Mr-Cosine/EMG/Electronics/EMG sensor front end/layout/EMGintegrated/Assembly/unit.SLDASM

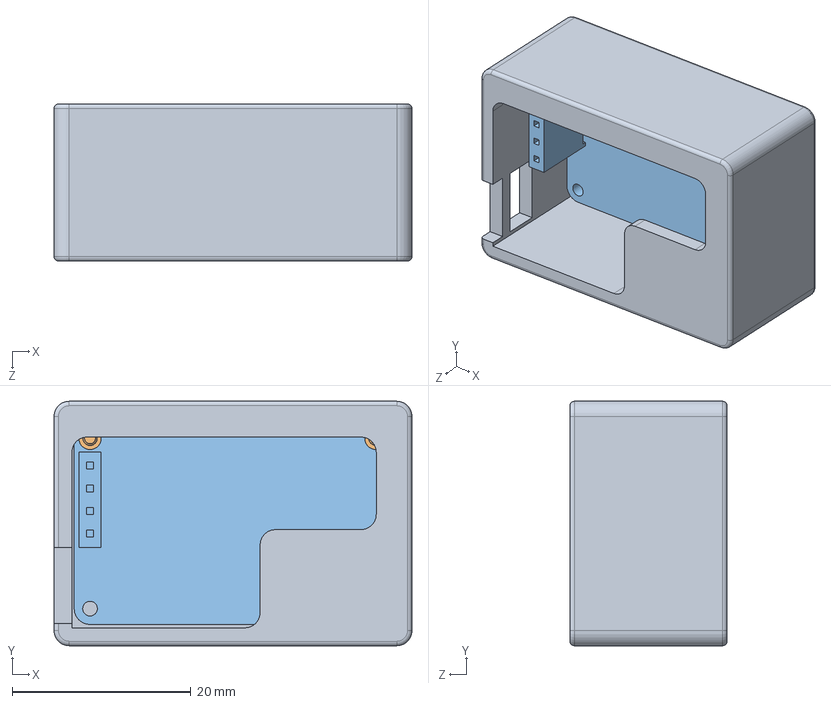
[picture p1: CAD file, 2026-11-11]
Electronics/EMG sensor front end/layout/EMGintegrated/Assembly/unit.SLDASM
40.1 x 27.4 x 17.6 mm
electrode
spacer x 3
