Mr-Cosine/EMG/Mechanical/finger/pinky nail v4.SLDASM

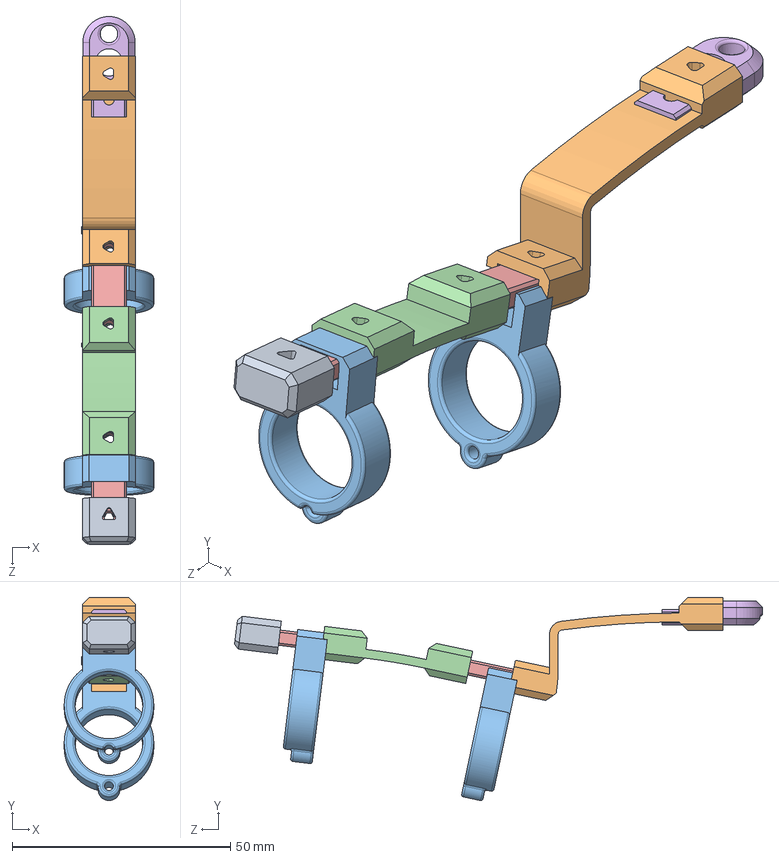
[picture p2: CAD file, 2026-10-28]
Mechanical/finger/pinky nail v4.SLDASM
20.5 x 46.5 x 120.8 mm
central support v5
beam v5 x 2
connector v5
new ring v5 x 2
connector - big v5
connector - tip v5
