Mr-Cosine/EMG/Mechanical/new hand - metal glider v5.SLDASM

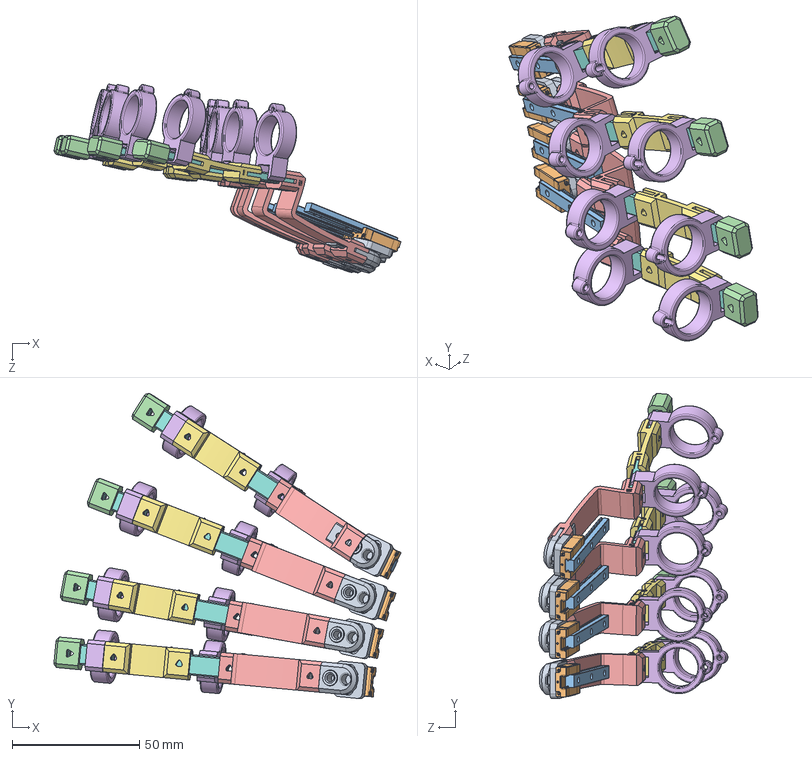
[picture p3: CAD file, 2026-10-28]
Mechanical/new hand - metal glider v5.SLDASM
136.6 x 120.2 x 74.3 mm
central support v5 x 4
beam v5 x 8
connector v5 x 4
new ring v5 x 8
connector - big v5 x 4
connector - tip v5 x 4
rail x 4
glider - metal x 4
glider base_4_CNC x 4
