Mr-Cosine/EMG/EMG fabric/finger/index&ring finger v4.SLDASM

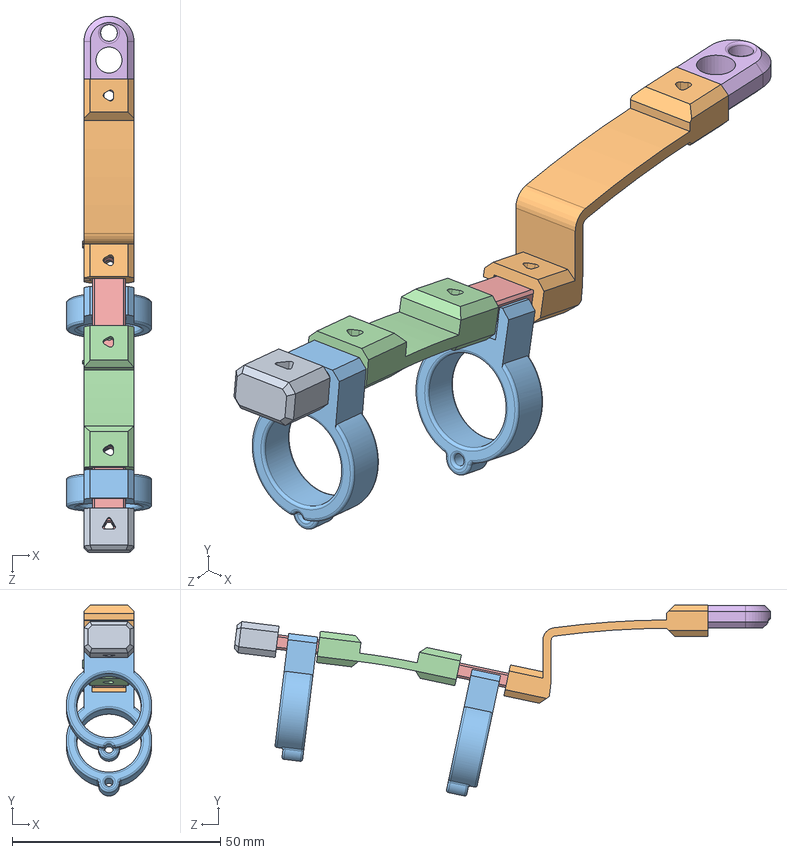
[picture p4: CAD file, 2026-09-22]
EMG fabric/finger/index&ring finger v4.SLDASM
20.5 x 45.8 x 128.7 mm
central support v5
beam v5 x 2
connector v5
new ring v5 x 2
connector - big v5
connector - tip v5
