Mr-Cosine/EMG/Mechanical/Arm/Hand/Hand.SLDASM

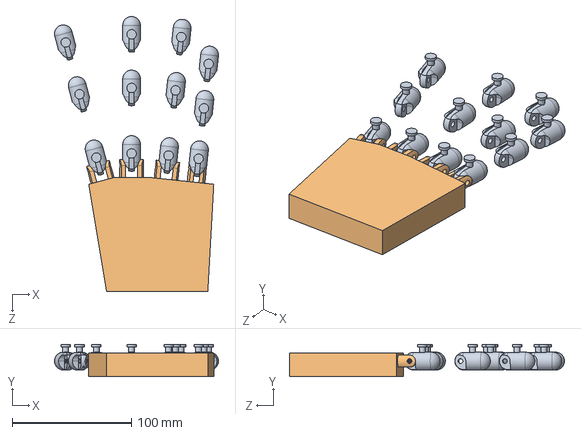
[picture p5: CAD file, 2026-11-11]
Mechanical/Arm/Hand/Hand.SLDASM
137.7 x 27.0 x 230.8 mm
palm
Finger_node x 12
