Mr-Cosine/EMG/Mechanical/Arm/Hand/Finger_smal.SLDASM

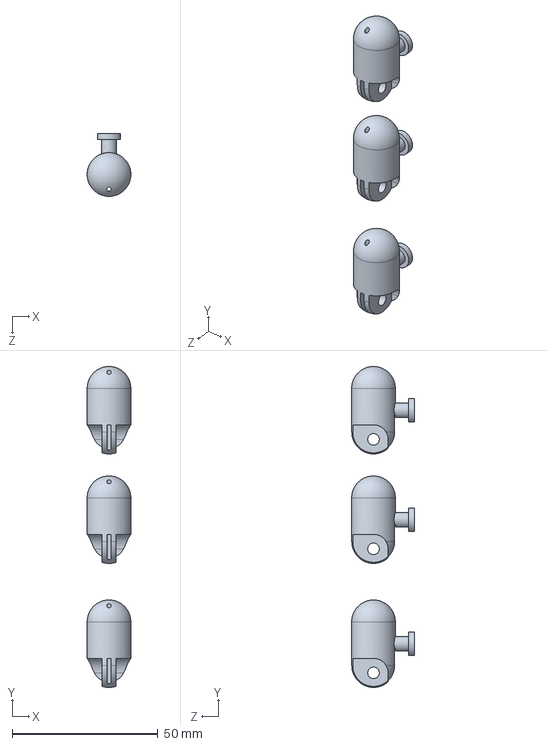
[picture p6: CAD file, 2026-11-11]
Mechanical/Arm/Hand/Finger_smal.SLDASM
15.0 x 110.0 x 21.5 mm
Finger_node x 3
