Mr-Cosine/EMG/Mechanical/Arm/Hand/Finger.SLDASM

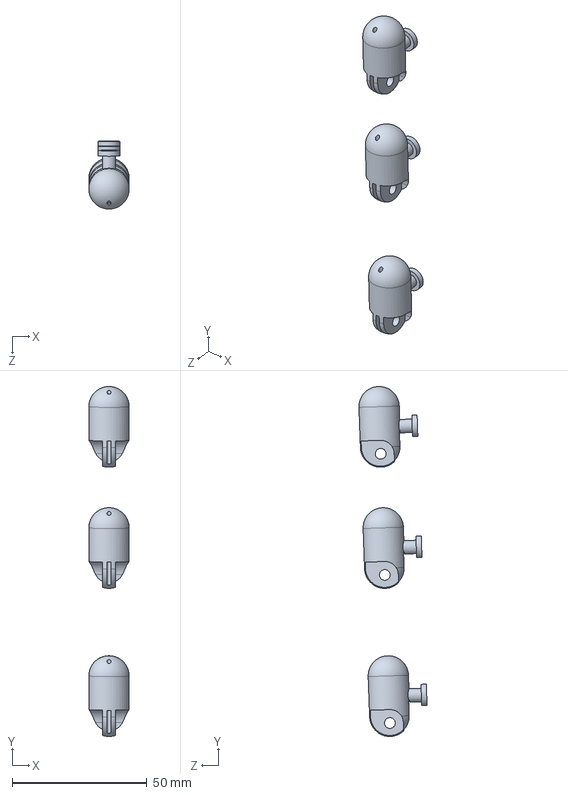
[picture p7: CAD file, 2026-11-11]
Mechanical/Arm/Hand/Finger.SLDASM
15.0 x 129.9 x 25.3 mm
Finger_node x 3
