Mr-Cosine/EMG/Electronics/EMG sensor front end/layout/EMGfrontend/Assembly/EMGfrontend.STEP

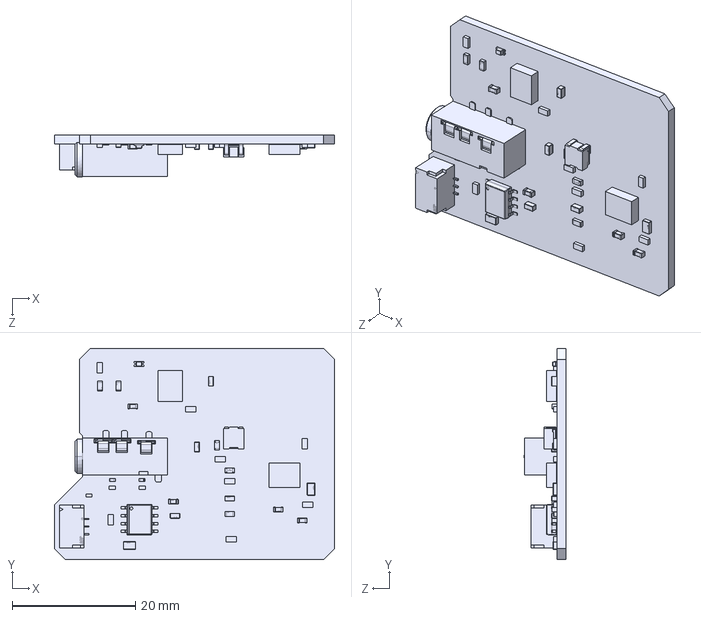
[picture p8: CAD file, 2026-11-10]
Electronics/EMG sensor front end/layout/EMGfrontend/Assembly/EMGfrontend.STEP
45.5 x 34.3 x 6.76 mm
