Mr-Cosine/EMG/EMG fabric/CAD drawing/glider base_4_CNC.STEP

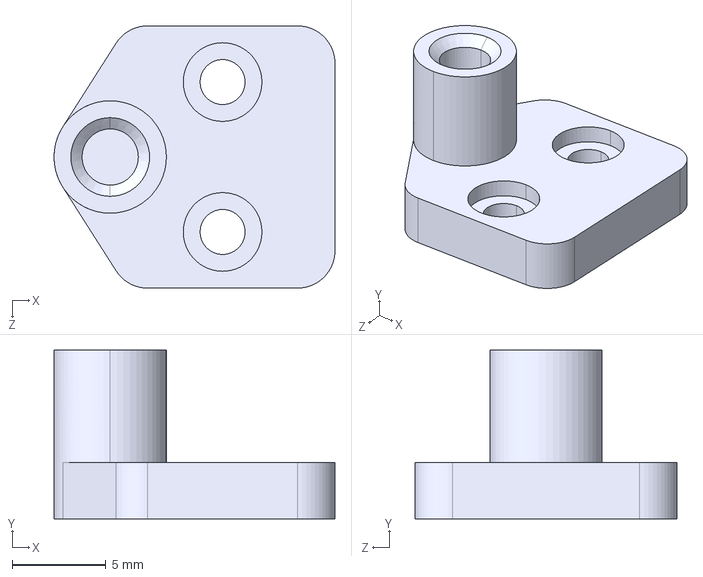
[picture p9: CAD file, 2026-09-22]
EMG fabric/CAD drawing/glider base_4_CNC.STEP
15.0 x 9.00 x 14.0 mm
