Mr-Cosine/EMG/EMG fabric/finger/connector - tip  v5.SLDPRT

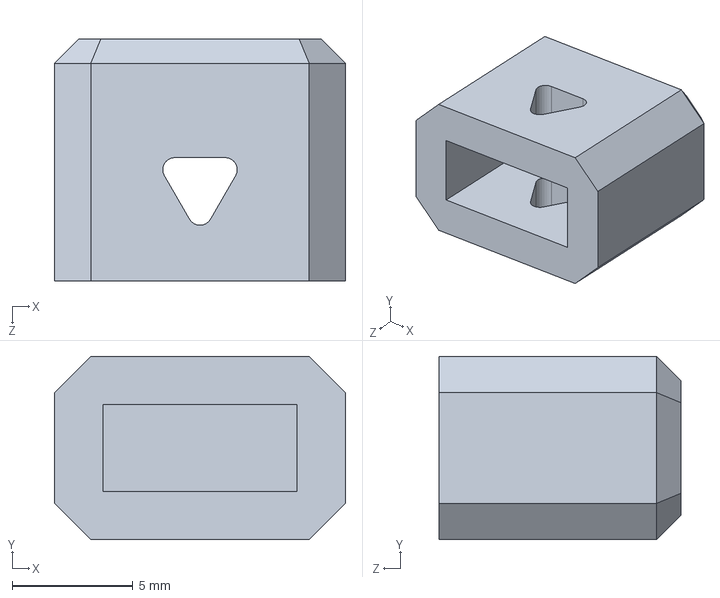
[picture p10: CAD file, 2026-09-22]
EMG fabric/finger/connector - tip v5.SLDPRT
12.0 x 7.58 x 10.0 mm
