Mr-Cosine/EMG/Mechanical/Arm/Hand/Finger_node_1-10scale.SLDPRT

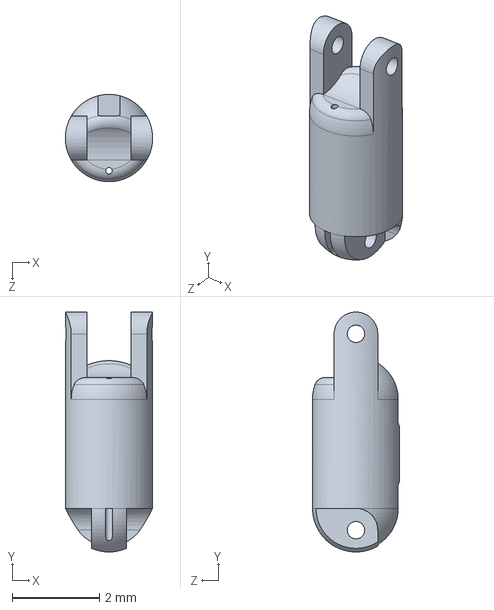
[picture p11: CAD file, 2026-11-11]
Mechanical/Arm/Hand/Finger_node_1-10scale.SLDPRT
2.00 x 5.50 x 2.00 mm
