Mr-Cosine/EMG/Electronics/EMG sensor front end/layout/EMGintegrated/Assembly/shell.SLDPRT

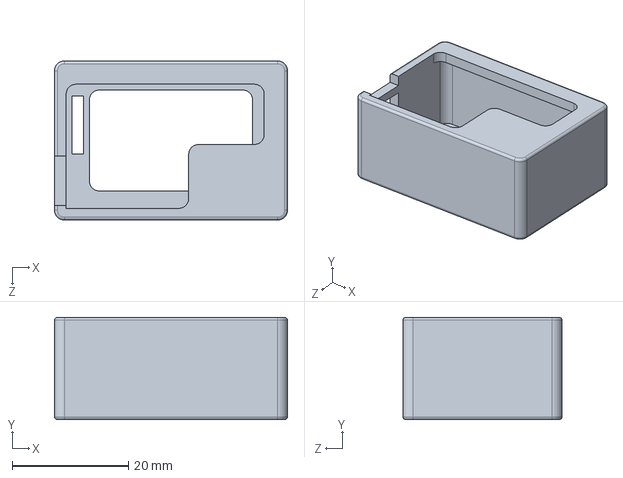
[picture p12: CAD file, 2026-11-11]
Electronics/EMG sensor front end/layout/EMGintegrated/Assembly/shell.SLDPRT
40.1 x 17.6 x 27.4 mm
