Mr-Cosine/EMG/Mechanical/Arm/Hand/palm.SLDPRT

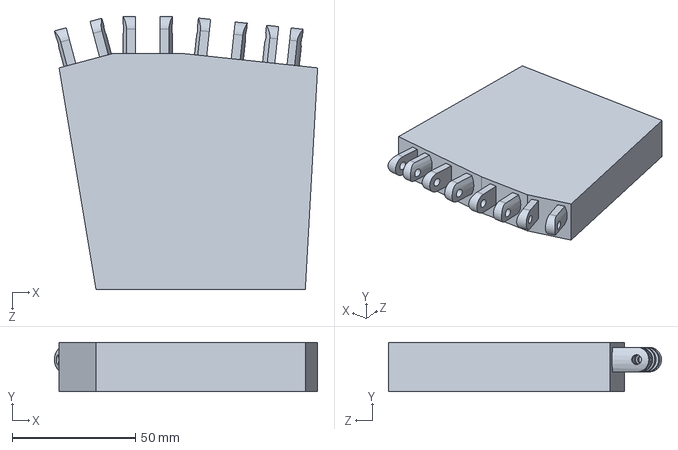
[picture p13: CAD file, 2026-11-11]
Mechanical/Arm/Hand/palm.SLDPRT
106.9 x 20.0 x 110.9 mm
