Mr-Cosine/EMG/Electronics/EMG sensor front end/layout/EMGintegrated/Assembly/electrode.SLDPRT

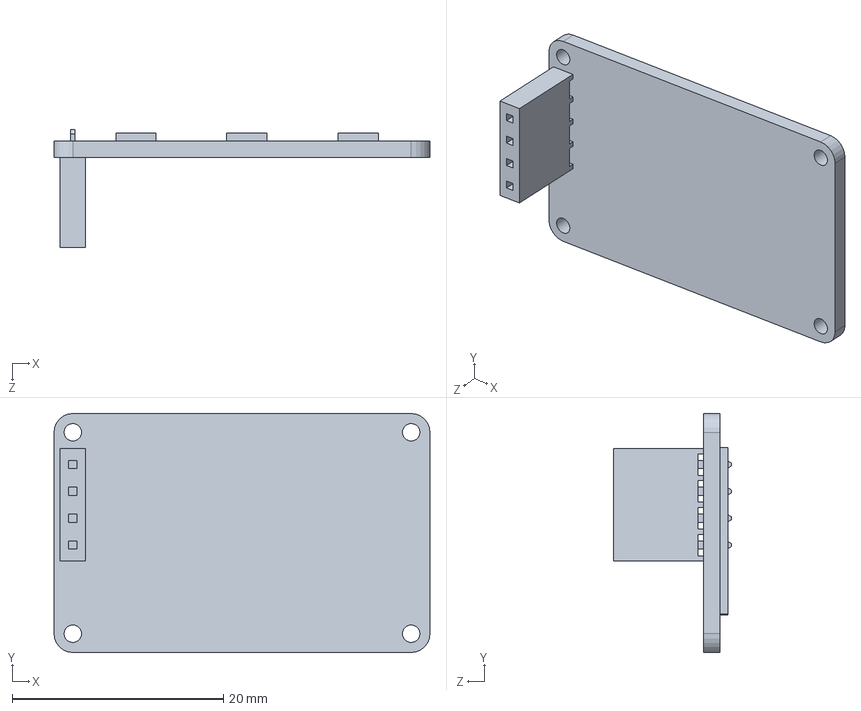
[picture p14: CAD file, 2026-11-10]
Electronics/EMG sensor front end/layout/EMGintegrated/Assembly/electrode.SLDPRT
35.6 x 22.6 x 11.2 mm
