Mr-Cosine/EMG/Mechanical/Arm/Hand/Finger_node.SLDPRT

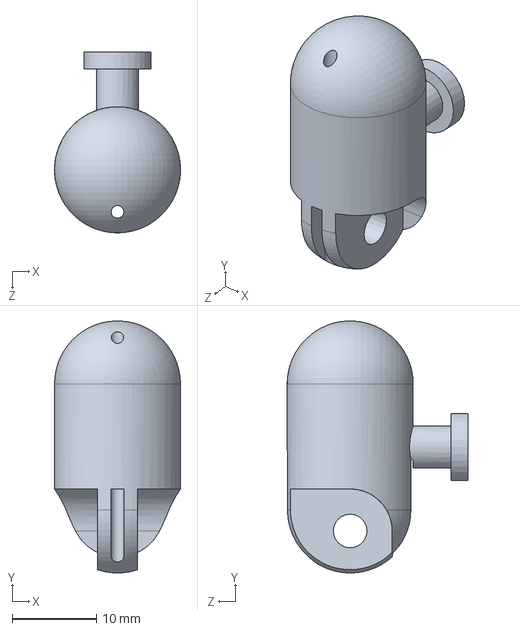
[picture p15: CAD file, 2026-11-11]
Mechanical/Arm/Hand/Finger_node.SLDPRT
15.0 x 30.0 x 21.5 mm
