Mr-Cosine/EMG/Mechanical/handpiece v6.SLDPRT

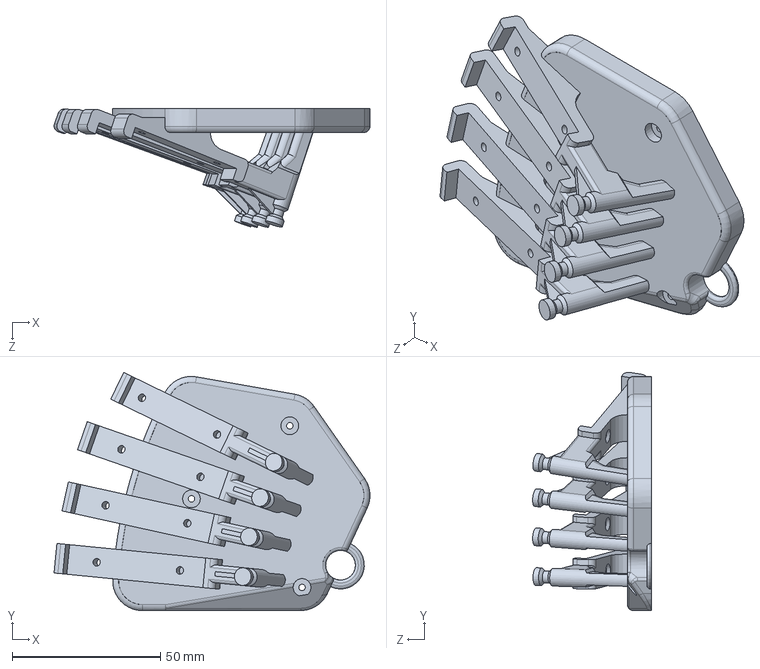
[picture p16: CAD file, 2026-09-29]
Mechanical/handpiece v6.SLDPRT
106.5 x 80.3 x 40.0 mm
