Mr-Cosine/EMG/Mechanical/Wearable hand exoskeleton/finger/connector v5.SLDPRT

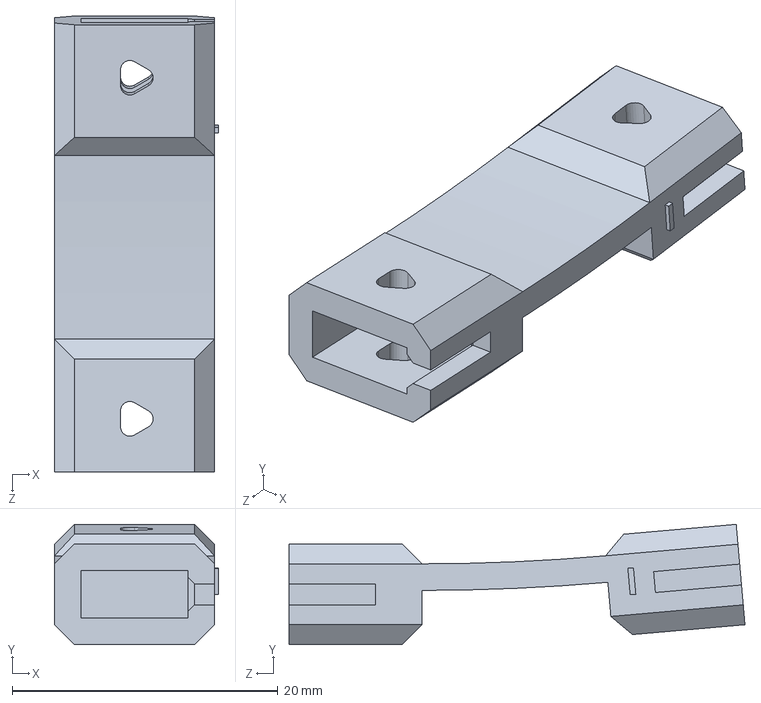
[picture p17: CAD file, 2026-11-11]
Mechanical/Wearable hand exoskeleton/finger/connector v5.SLDPRT
12.3 x 9.05 x 34.3 mm
