Mr-Cosine/EMG/Electronics/EMG sensor front end/layout/EMGintegrated/Assembly/EMGintegrated.SLDPRT

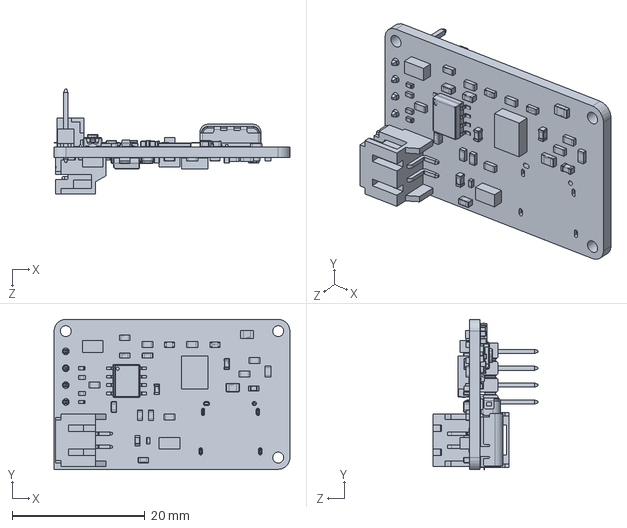
[picture p18: CAD file, 2026-11-10]
Electronics/EMG sensor front end/layout/EMGintegrated/Assembly/EMGintegrated.SLDPRT
35.6 x 22.6 x 15.8 mm
