Mr-Cosine/EMG/EMG fabric/finger/connector - big v5.SLDPRT

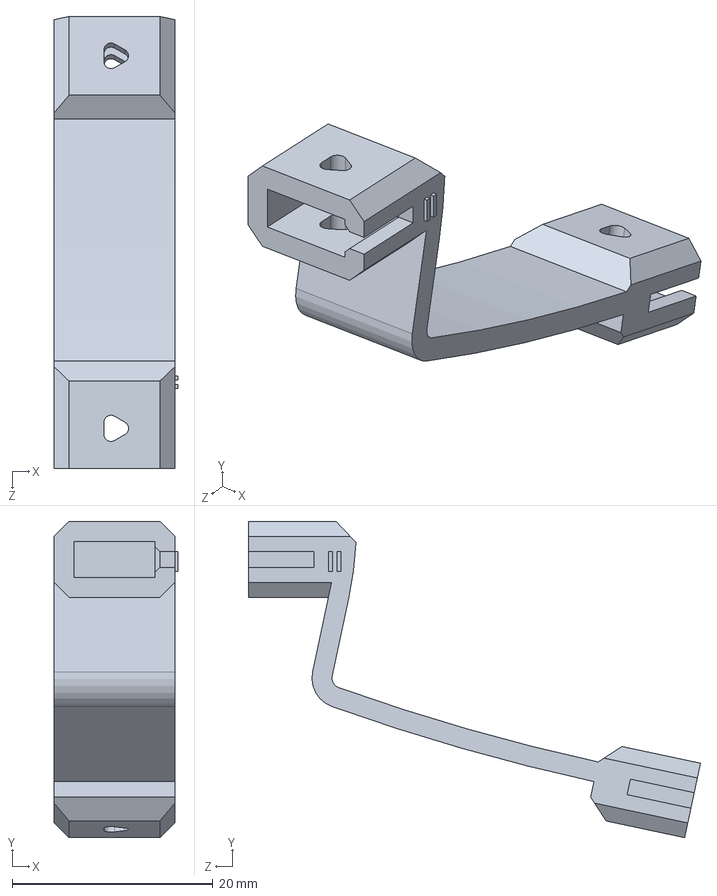
[picture p19: CAD file, 2026-09-22]
EMG fabric/finger/connector - big v5.SLDPRT
12.3 x 31.5 x 45.0 mm
