Mr-Cosine/EMG/Mechanical/armband_base.SLDPRT

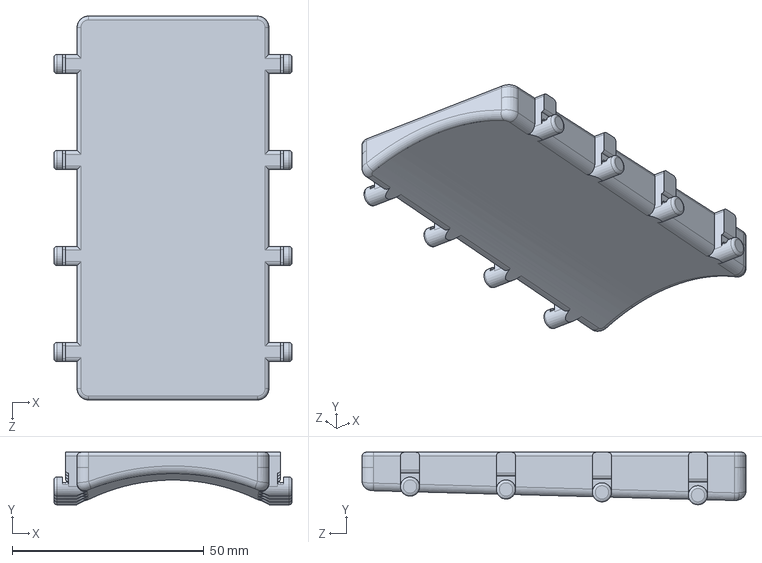
[picture p20: CAD file, 2026-09-22]
Mechanical/armband_base.SLDPRT
62.0 x 13.7 x 100.0 mm
