Mr-Cosine/EMG/Electronics/EMG sensor front end/layout/EMGintegrated/Assembly/spacer.SLDPRT

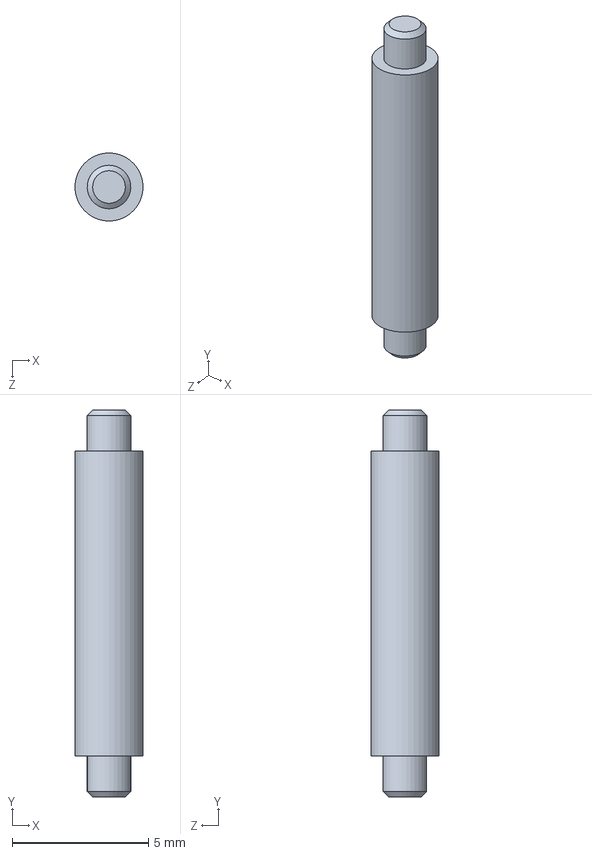
[picture p21: CAD file, 2026-11-10]
Electronics/EMG sensor front end/layout/EMGintegrated/Assembly/spacer.SLDPRT
2.49 x 14.2 x 2.50 mm
