Mr-Cosine/EMG/EMG fabric/finger/central support v5.SLDPRT

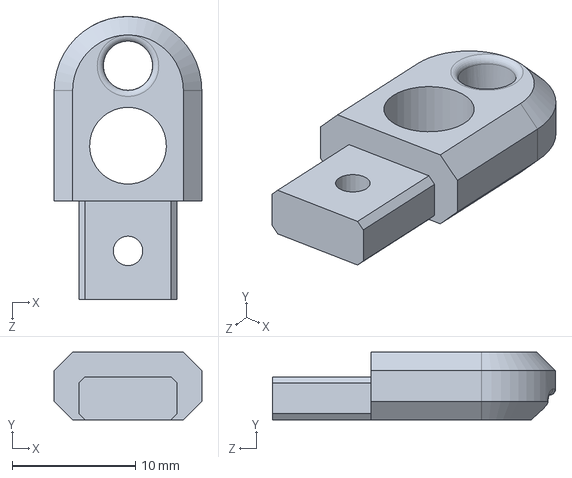
[picture p22: CAD file, 2026-09-22]
EMG fabric/finger/central support v5.SLDPRT
12.0 x 5.50 x 23.0 mm
