Mr-Cosine/EMG/Mechanical/Wearable hand exoskeleton/finger/new ring v5.SLDPRT

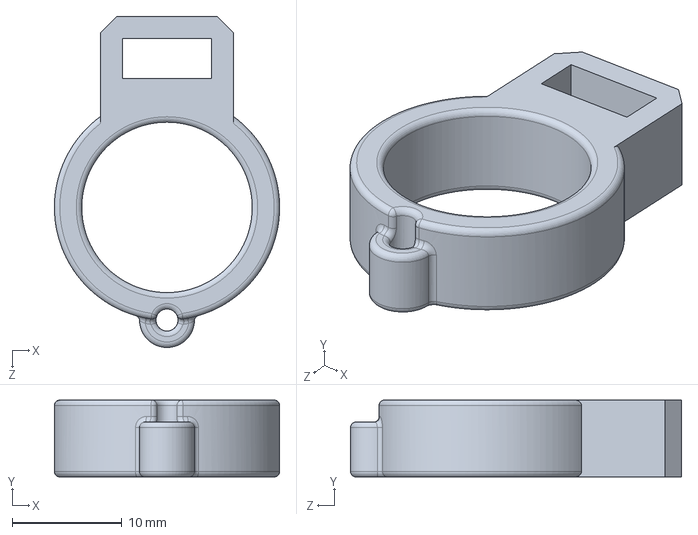
[picture p23: CAD file, 2026-09-22]
Mechanical/Wearable hand exoskeleton/finger/new ring v5.SLDPRT
20.5 x 7.00 x 30.1 mm
