Mr-Cosine/EMG/EMG fabric/finger/beam v5.SLDPRT

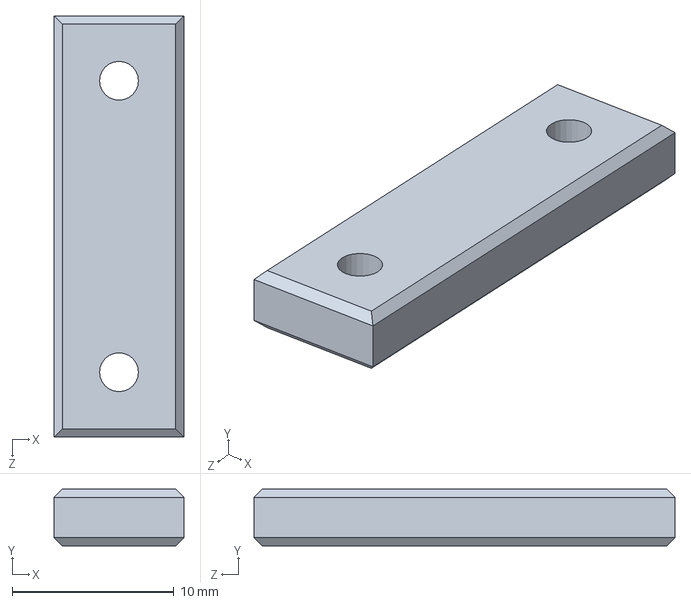
[picture p24: CAD file, 2026-09-05]
EMG fabric/finger/beam v5.SLDPRT
8.00 x 3.50 x 26.0 mm
