Mr-Cosine/EMG/EMG fabric/finger/rail.SLDPRT

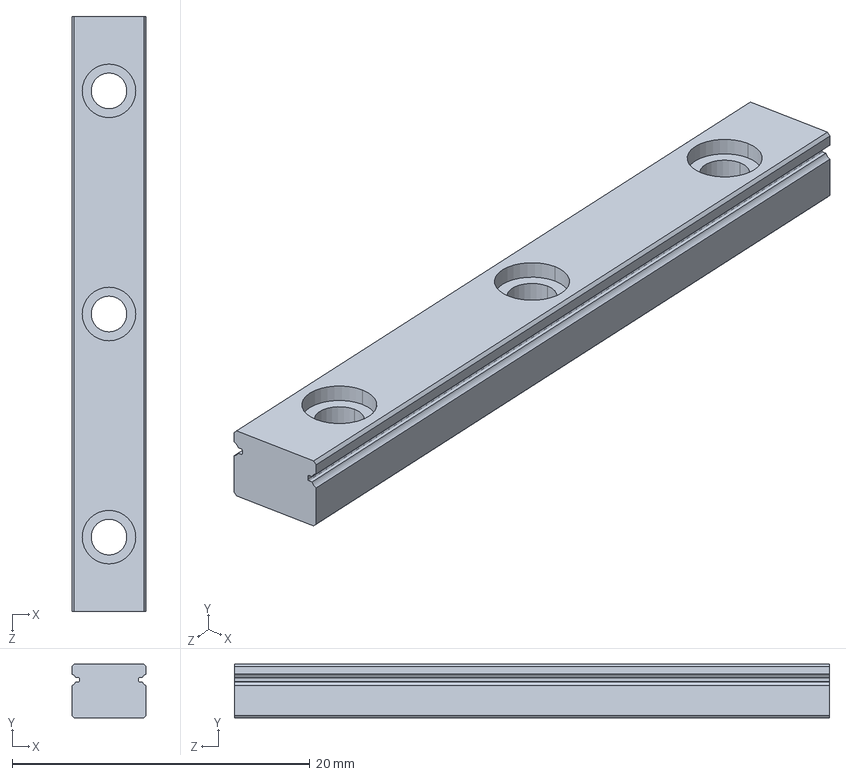
[picture p25: CAD file, 2026-09-05]
EMG fabric/finger/rail.SLDPRT
5.00 x 3.60 x 40.0 mm
