Mr-Cosine/EMG/EMG fabric/finger/glider fix.SLDPRT

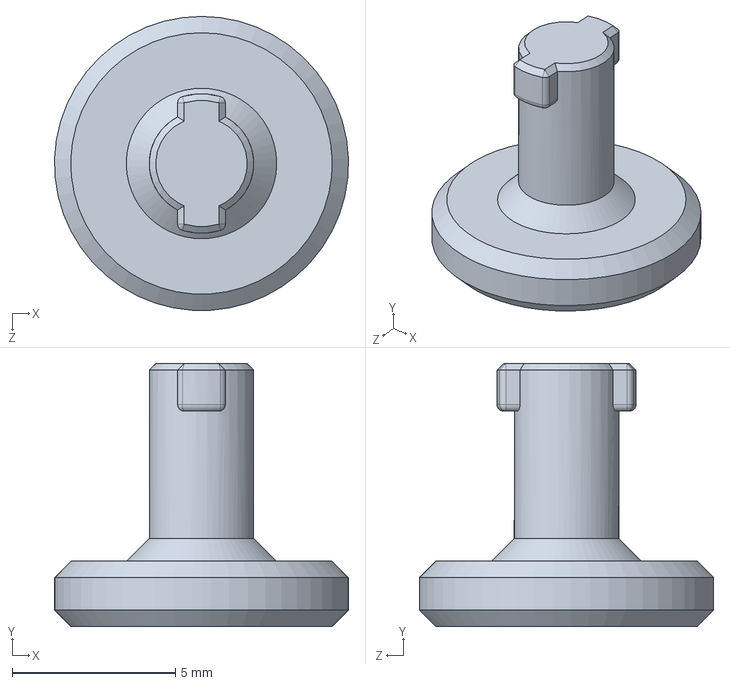
[picture p26: CAD file, 2026-09-05]
EMG fabric/finger/glider fix.SLDPRT
9.00 x 8.05 x 9.00 mm
