Mr-Cosine/EMG/EMG fabric/finger/glider - metal.SLDPRT

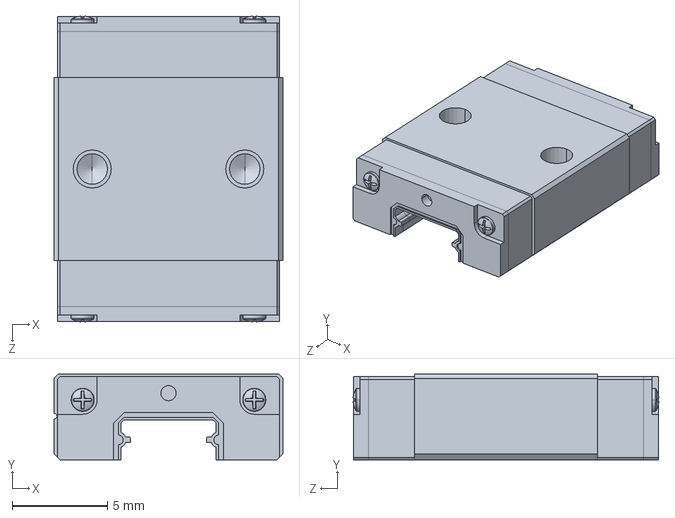
[picture p27: CAD file, 2026-09-05]
EMG fabric/finger/glider - metal.SLDPRT
12.0 x 4.50 x 16.0 mm
