Mr-Cosine/EMG/EMG fabric/finger/glider base.SLDPRT

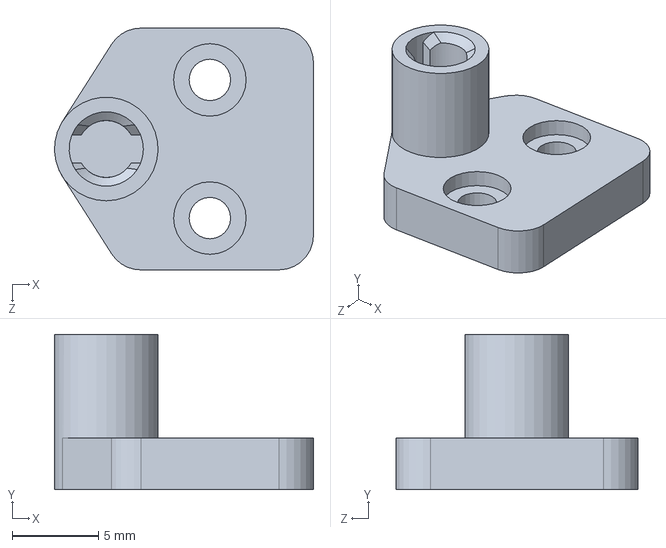
[picture p28: CAD file, 2026-09-05]
EMG fabric/finger/glider base.SLDPRT
15.0 x 9.00 x 14.0 mm
