Mr-Cosine/EMG/(list of files, cad)

Other CAD files:
Mechanical/finger/middle finger v4.SLDASM
Mechanical/Wearable hand exoskeleton/finger/index&ring finger v4.SLDASM
EMG fabric/finger/pinky nail v4.SLDASM
Mechanical/Wearable hand exoskeleton/finger/connector - tip v5.SLDPRT
Mechanical/Wearable hand exoskeleton/finger/connector - big v5.SLDPRT
EMG fabric/finger/connector v5.SLDPRT
EMG fabric/finger/glider base_4_CNC.SLDPRT
EMG fabric/CAD drawing/glider base_4_CNC_easy.SLDDRW
EMG fabric/handpiece v5.SLDPRT
EMG fabric/legacy files/v1/legacy finger/Index finger v1.SLDASM
EMG fabric/legacy files/v1/legacy finger/Thumb.SLDASM
EMG fabric/legacy files/v1/legacy finger/central support generic.SLDPRT
EMG fabric/legacy files/v2/finger/beam v2.SLDPRT
EMG fabric/legacy files/v2/finger/connector - tip v2.SLDPRT
EMG fabric/legacy files/v2/finger/index&ring finger v2.SLDASM
EMG fabric/legacy files/v2/finger/new ring v2.SLDPRT
EMG fabric/legacy files/v3/finger/beam v3.SLDPRT
EMG fabric/legacy files/v3/finger/central support v3.SLDPRT
EMG fabric/legacy files/v3/finger/connector - tip v3.SLDPRT
EMG fabric/legacy files/v3/finger/connector v3.SLDPRT
EMG fabric/legacy files/v3/new hand - circular glider.SLDASM
EMG fabric/legacy files/v4/finger/connector v4.SLDPRT
EMG fabric/legacy files/v4/finger/index&ring finger v4.SLDASM
EMG fabric/legacy files/v4/finger/middle finger v4.SLDASM
EMG fabric/legacy files/v4/handpiece v4.SLDPRT
EMG fabric/legacy files/v4/new hand - metal glider (v4).SLDASM
EMG fabric/legacy files/v5/CAD drawing/glider base_4_CNC_easy.SLDDRW
EMG fabric/legacy files/v5/finger/connector v5.SLDPRT
EMG fabric/legacy files/v5/finger/pinky nail v4.SLDASM
EMG fabric/legacy files/v5/new hand - metal glider v5.SLDASM
EMG fabric/new hand - metal glider v5.SLDASM
Mechanical/Wearable hand exoskeleton/legacy files/armpiece.SLDPRT
Mechanical/Wearable hand exoskeleton/legacy files/v1/hand.SLDASM
Mechanical/Wearable hand exoskeleton/legacy files/v1/handpiece v1.SLDPRT
Mechanical/Wearable hand exoskeleton/legacy files/v1/legacy finger/Middle finger v1.SLDASM
Mechanical/Wearable hand exoskeleton/legacy files/v1/legacy finger/Ring finger v1.SLDASM
Mechanical/Wearable hand exoskeleton/legacy files/v1/legacy finger/ring v1.SLDPRT
Mechanical/Wearable hand exoskeleton/legacy files/v2/finger/central support v2.SLDPRT
Mechanical/Wearable hand exoskeleton/legacy files/v2/finger/connector v2.SLDPRT
Mechanical/Wearable hand exoskeleton/legacy files/v2/finger/glider fix.SLDPRT
Mechanical/Wearable hand exoskeleton/legacy files/v2/finger/pinky nail v2.SLDASM
Mechanical/Wearable hand exoskeleton/legacy files/v2/handpiece v2.SLDPRT
Mechanical/Wearable hand exoskeleton/legacy files/v2/new hand - normal glider.SLDASM
Mechanical/Wearable hand exoskeleton/legacy files/v2/plug.SLDPRT
Mechanical/Wearable hand exoskeleton/legacy files/v3/finger/connector - Copy v3.SLDPRT
Mechanical/Wearable hand exoskeleton/legacy files/v3/finger/glider v3.SLDPRT
Mechanical/Wearable hand exoskeleton/legacy files/v3/finger/index&ring finger v3.SLDASM
Mechanical/Wearable hand exoskeleton/legacy files/v3/finger/middle finger v3.SLDASM
Mechanical/Wearable hand exoskeleton/legacy files/v3/finger/new ring v3.SLDPRT
Mechanical/Wearable hand exoskeleton/legacy files/v3/finger/pinky nail v3.SLDASM
Mechanical/Wearable hand exoskeleton/legacy files/v3/handpiece v3.SLDPRT
Mechanical/Wearable hand exoskeleton/legacy files/v4/finger/connector - big v4.SLDPRT
Mechanical/Wearable hand exoskeleton/legacy files/v4/finger/connector - tip v4.SLDPRT
Mechanical/Wearable hand exoskeleton/legacy files/v4/finger/new ring v4.SLDPRT
Mechanical/Wearable hand exoskeleton/legacy files/v5/handpiece v5.SLDPRT
Mechanical/handpiece v5.SLDPRT
Mechanical/legacy files/v1/legacy finger/Pinky nail v1.SLDASM
Mechanical/legacy files/v2/finger/connector - Copy v2.SLDPRT
Mechanical/legacy files/v2/finger/glider.SLDPRT
Mechanical/legacy files/v2/finger/middle finger v2.SLDASM
Mechanical/legacy files/v3/finger/glider fix v3.SLDPRT
Mechanical/legacy files/v4/finger/beam v4.SLDPRT
Mechanical/legacy files/v4/finger/central support v4.SLDPRT
Mechanical/legacy files/v4/finger/pinky nail v4.SLDASM
Mechanical/legacy files/v4/handpiece v4-lower.SLDPRT
Mechanical/legacy files/v5/finger/glider base_4_CNC.SLDPRT
