Mr-Cosine/EMG/Softwares/EMGsignal/test/how_to_test.txt

1. Compile filter_exported.cpp, make it into build folder
2. toggle the test constants in signal_gen.py
3. run
