Mr-Cosine/EMG/Electronics/EMG sensor front end/simulation/Virtual Ground.asc

B1: bv; V=7m*sin(2*pi*(10*time + 9995*time*time))
C1: cap; 1µ
C2: cap; 1µ
C3: cap; 20n
C4: cap; 10n
C5: cap; 22n
C6: cap; 1µ
C7: cap; 1µ
R1: res; 10K
R2: res; 10K
R3: res; 15k
R4: res; 11k
R5: res; 1k
R6: res; 51k
R7: res; 1k
R8: res; 22k
R9: res; 22k
R10: res; 470
R11: res; 5.6k
R12: res; 10
U1: UniversalOpAmp2
U2: AD8226
U3: UniversalOpAmp2
U4: UniversalOpAmp2
U5: UniversalOpAmp2
V1: voltage; 3.3
V2: voltage; SINE(0 1.4mV 125)
V3: voltage; SINE(0 1.4mV 250)
V4: voltage; SINE(0 1.4mV 500)
V5: voltage; SINE(0 1.4mV 1000)
V6: voltage; SINE(0 1.4mV 2000)
V7: voltage; SINE(0 7mV 200)
Named nets: 0, VREF, SIGNAL, VSOURCE, AMPOUT, RCHPFOUT, GAINOUT, PROCESSED, ADC
.tran 0.5
