Mr-Cosine/EMG/(list of files, drawings)

Other design files:
Electronics/EMG sensor front end/layout/EMGfrontend/AMP1.SchDoc
Electronics/EMG sensor front end/layout/EMGfrontend/EMGfrontend.SchDoc
Electronics/EMG sensor front end/layout/EMGfrontend/EMGfrontend.SCHLIB
Electronics/EMG sensor front end/layout/EMGintegrated/AMP1.SchDoc
Electronics/EMG sensor front end/layout/EMGintegrated/AMP2.SchDoc
Electronics/EMG sensor front end/layout/EMGintegrated/Electrode/Electrode/electrode.PcbDoc
Electronics/EMG sensor front end/layout/EMGintegrated/Electrode/Electrode/electrode.PcbLib
Electronics/EMG sensor front end/layout/EMGintegrated/Electrode/Electrode/Electrode.PrjPcb
Electronics/EMG sensor front end/layout/EMGintegrated/Electrode/Electrode/electrode.SchDoc
Electronics/EMG sensor front end/layout/EMGintegrated/Electrode/Electrode/Electrode.SCHLIB
Electronics/EMG sensor front end/layout/EMGintegrated/Electrode/Electrode/SAMTEC_SSW-104-01-G-S.PcbLib
Electronics/EMG sensor front end/layout/EMGintegrated/Electrode/Electrode/SSW-104-01-G-S.SchLib
Electronics/EMG sensor front end/layout/EMGintegrated/EMGfrontend.PcbLib
Electronics/EMG sensor front end/layout/EMGintegrated/EMGfrontend.SchDoc
Electronics/EMG sensor front end/layout/EMGintegrated/EMGintegrated.PcbDoc
Electronics/EMG sensor front end/layout/EMGintegrated/EMGintegrated.PcbLib
Electronics/EMG sensor front end/layout/EMGintegrated/EMGintegrated.PrjPcb
Electronics/EMG sensor front end/layout/EMGintegrated/EMGintegrated.SchDoc
Electronics/EMG sensor front end/layout/EMGintegrated/EMGintegrated.SCHLIB
Electronics/EMG sensor front end/layout/EMGintegrated/HPF(20Hz).SchDoc
Electronics/EMG sensor front end/layout/EMGintegrated/JST_S2B-PH-SM4-TB.PcbLib
Electronics/EMG sensor front end/layout/EMGintegrated/KMR221GLFS.SchLib
Electronics/EMG sensor front end/layout/EMGintegrated/LPF(500Hz).SchDoc
Electronics/EMG sensor front end/layout/EMGintegrated/Powereg.SchDoc
Electronics/EMG sensor front end/layout/EMGintegrated/S2B-PH-SM4-TB.SchLib
Electronics/EMG sensor front end/layout/EMGintegrated/SW_KMR221GLFS.PcbLib
Electronics/EMG sensor front end/layout/EMGintegrated/voltage_regulator.SchDoc
Electronics/EMG sensor front end/layout/EMGintegrated/VREF.SchDoc
Electronics/EMG sensor front end/layout/PCB_Project/AMP2.SchDoc
Electronics/EMG sensor front end/layout/PCB_Project/EMGfrontend.PcbDoc
Electronics/EMG sensor front end/layout/PCB_Project/EMGfrontend.PcbLib
Electronics/EMG sensor front end/layout/PCB_Project/EMGfrontend.PrjPcb
Electronics/EMG sensor front end/layout/PCB_Project/EMGfrontend.SchDoc
Electronics/EMG sensor front end/layout/PCB_Project/EMGfrontend.SCHLIB
Electronics/EMG sensor front end/layout/PCB_Project/HPF(20Hz).SchDoc
Electronics/EMG sensor front end/layout/PCB_Project/LPF(500Hz).SchDoc
Electronics/EMG sensor front end/layout/PCB_Project/VREF.SchDoc
Electronics/motor test/PCB_testboard/PCB_testboard.PrjPcb
Electronics/motor test/PCB_testboard/Sheet1.SchDoc
PCB design/EMG/layout/PCB_Project/AMP1.SchDoc
PCB design/EMG/layout/PCB_Project/AMP2.SchDoc
PCB design/EMG/layout/PCB_Project/EMGfrontend.PcbDoc
PCB design/EMG/layout/PCB_Project/EMGfrontend.PrjPcb
PCB design/EMG/layout/PCB_Project/EMGfrontend.SchDoc
PCB design/EMG/layout/PCB_Project/HPF(20Hz).SchDoc
PCB design/EMG/layout/PCB_Project/LPF(500Hz).SchDoc
PCB design/EMG/layout/PCB_Project/VREF.SchDoc
Softwares/StepperMotor/PCB_TESTBOARD/PCB_testboard/PCB_testboard.PrjPcb
Softwares/StepperMotor/PCB_TESTBOARD/Sheet1.SchDoc
StepperMotor/PCB_TESTBOARD/PCB_testboard/PCB1.PcbDoc
