Mr-Cosine/EMG/Softwares/StepperMotor/motor_setup/motor_setup.py

import json
import prettier_console as UI
from prettier_console import default_colored_output as coutput
from prettier_console import default_line_counter as line_counter
from serial import Serial
import time
import os

DEBUG_MODE = False

if os.path.exists("motor_config.json"):
    with open("motor_config.json", "r") as motor_config:
        try:
            config = json.load(motor_config)
        except json.decoder.JSONDecodeError:
            config = {}
else:
    config = {}

pin = config.get("pin", None)
actuation_length = config.get("actuation_length", {}) or {}
interstep_delay = config.get("interstep_delay", {}) or {}

port = None
port_name = None

#-------------------------------------------------------------------------------------------------
#   Communication with Arduino
#-------------------------------------------------------------------------------------------------

COMMAND_LIST = {
    "forward": "FWD",
    "backward": "BWD",
    "set_speed": "SPD",
    "set_delay_min": "DMIN",
    "set_delay_max": "DMAX",
    "set_pin_IN1": "PIN1",
    "set_pin_IN2": "PIN2",
    "set_pin_IN3": "PIN3",
    "set_pin_IN4": "PIN4",
}
def send(port, cmd, data = None):
    if cmd not in COMMAND_LIST: raise ValueError("Unexpected command error.")

    if port is not None:
        port.reset_input_buffer()
        port.write((COMMAND_LIST[cmd] + "," + str(data) + "\n").encode())
        return port.readline().decode(errors="replace").strip()

#-------------------------------------------------------------------------------------------------
#   Connect to the Arduino board
#-------------------------------------------------------------------------------------------------

def set_serial():
    UI.clear_screen()

    global port, port_name
    import serial.tools.list_ports
    all_port = serial.tools.list_ports.comports()

    options = [
        {
            "text": f"{port.device} - {port.description}",
            "color": "cyan",
            "id": port.device
        }
        for port in all_port
    ]

    print("Choosing the serial port connected to the Arduino board.")
    print("Notice: the serial port has bluetooth is not the port for Arduino, connecting them will result a fail.")

    port_name_temp = UI.print_selections(f"Select from the following port(check Arduino IDE for board connection):", options)
    try:
        port_temp = Serial(port_name_temp, 9600, timeout=5)
    except Exception as e:
        coutput.print(f"Connection failed: {e}, please retry.", color="red")
        UI.safe_input("Press enter to return.")
        return

    print("Waiting for board to boot...")
    BOOT_TIMEOUT = 10  # total seconds to wait before giving up
    deadline = time.time() + BOOT_TIMEOUT
    ready = False

    while time.time() < deadline:
        line = port_temp.readline().decode(errors="replace").strip()
        if line == "READY":
            ready = True
            break
        # empty or unrelated line — keep polling until the deadline

    if not ready:
        print(f"No response from {port_name_temp} within {BOOT_TIMEOUT}s.")
        print("Check the cable/port and try again.")
        port_temp.close()
        UI.safe_input("Press enter to return.")
        return

    if port is not None and port.is_open: port.close()
    port_name = port_name_temp
    port = port_temp

    print("Board ready.")

#-------------------------------------------------------------------------------------------------
#   Set pins for motor
#-------------------------------------------------------------------------------------------------

def setup_pin():
    UI.clear_screen()

    global pin
    DIGITAL_PINS = list(range(2, 14))
    selected = {}

    for index in range(1, 5):
        name = f"IN{index}"
        # only offer the pins that are not taken by a previous entry
        options = [
            {
                "text": f"D{digital_pin}",
                "color": "cyan",
                "id": str(digital_pin)
            }
            for digital_pin in DIGITAL_PINS if digital_pin not in selected.values()
        ]

        print("Setting up for the pin layout.")
        if selected:
            print("Assigned so far: ")
            coutput.print("\n".join(f"{key}->D{value}" for key, value in selected.items()), color="yellow")
        print()
        selected[name] = int(UI.print_selections(f"Choose the digital pin wired to {name}:", options))
        UI.clear_screen()

    UI.clear_screen()
    print("Setting up for the pin layout.")
    print("New pin layout:")
    for name, digital_pin in selected.items():
        print(f"    {name} -> D{digital_pin}")
    print()

    if UI.print_yesorno("Keep this layout?") == 'y':
        pin = selected
        print("Pin layout updated.")
        for name, digital_pin in selected.items():
            send(port, f"set_pin_{name}", digital_pin)
    else:
        print("Pin layout unchanged.")

    UI.safe_input("Press enter to return.")

#-------------------------------------------------------------------------------------------------
#   Set actuation length
#-------------------------------------------------------------------------------------------------

def setup_length():
    UI.clear_screen()

    global port
    if port is None:
        print("No serial port connected — set the serial port first.")
        if not DEBUG_MODE:
            UI.safe_input("Press enter to return.")
            return
        else:
            response = UI.print_yesorno("Continue?")
            if response != "y": return

    print("Caliberating actuation length.")
    print("Move the motor to the bottom.")
    print("Select yes to go backward once(10 actuation cycle). Until motor slider is at the starting point.")
    response = 'y'
    while(response == 'y'):
        line_counter.reset()
        response = UI.print_yesorno("Continue?")
        if response == 'y':
            send(port, "backward")
        UI.clear_lines(line_counter.printed_lines())

    print("Move the motor to the tip.")
    print("Select yes to go forward once(10 actuation cycle). Until motor slider is at the starting point.")
    cycle_counter = 0
    response = 'y'
    while(response == 'y'):
        line_counter.reset()
        response = UI.print_yesorno("Continue?")
        if response == 'y':
            send(port, "forward")
            cycle_counter += 1
        UI.clear_lines(line_counter.printed_lines())

    actuation_length['forward'] = cycle_counter * 10

    print("Move the motor back to the bottom.")
    print("Select yes to go backward once(10 actuation cycle). Until motor slider is at the starting point.")
    cycle_counter = 0
    response = 'y'
    while(response == 'y'):
        line_counter.reset()
        response = UI.print_yesorno("Continue?")
        if response == 'y':
            send(port, "backward")
            cycle_counter += 1
        UI.clear_lines(line_counter.printed_lines())

    actuation_length['backward'] = cycle_counter * 10

#-------------------------------------------------------------------------------------------------
#   Set interstep delay (determines speed)
#-------------------------------------------------------------------------------------------------

def _test_motor_menu():

    """Let the user repeatedly jog the motor forward/backward at the current settings."""
    
    while True:
        line_counter.reset()
        direction = UI.print_selections("Test the motor at this speed:", [
            {"text": "Forward", "color": "cyan", "id": "forward"},
            {"text": "Backward", "color": "cyan", "id": "backward"},
            {"text": "Done testing", "color": "yellow", "id": "done"}
        ])
        UI.clear_lines(line_counter.printed_lines())
        if direction == "done": return
        send(port, direction)

def _set_delay(step_label, config_key, command_key):
    print(f"Setting the {step_label} inter-step delay.")
    while True:
        entry = UI.safe_input(f"Enter {step_label.lower()} delay in ms: ").strip()
        try:
            value = int(entry)
        except ValueError:
            print(f"'{entry}' is not a whole number, try again.")
            continue
        if value < 0:
            print("Delay can't be negative, try again.")
            continue
        break

    send(port, command_key, value)
    print(f"{step_label.capitalize()} delay set to {value}ms.")
    print()
    _test_motor_menu()

    if UI.print_yesorno(f"Keep this {step_label.lower()} delay?") == 'y':
        interstep_delay[config_key] = value
        print(f"{step_label.capitalize()} delay saved.")
    else:
        print(f"{step_label.capitalize()} delay discarded.")
    UI.safe_input("Press enter to continue.")

def setup_delay():
    UI.clear_screen()

    global port
    if port is None:
        print("No serial port connected — set the serial port first.")
        if not DEBUG_MODE:
            UI.safe_input("Press enter to return.")
            return
        else:
            response = UI.print_yesorno("Continue?")
            if response != "y": return

    print("Adjusting inter-step delay.")
    print()

    _set_delay("MINIMUM (fastest speed)", "min", "set_delay_min")

    UI.clear_screen()
    _set_delay("MAXIMUM (slowest speed)", "max", "set_delay_max")

    if interstep_delay.get("min") is not None and interstep_delay.get("max") is not None:
        if interstep_delay["min"] >= interstep_delay["max"]:
            coutput.print(
                "Warning: minimum delay should normally be smaller than maximum delay "
                "(fast speed = shorter delay, slow speed = longer delay).",
                color="red"
            )
            UI.safe_input("Press enter to return.")

#-------------------------------------------------------------------------------------------------
#   Toggle debug mode
#-------------------------------------------------------------------------------------------------
def set_debug():
    UI.clear_screen()
    global DEBUG_MODE
    DEBUG_MODE = not DEBUG_MODE

#-------------------------------------------------------------------------------------------------
#   Quit
#-------------------------------------------------------------------------------------------------

def quit(save=True):
    if (save==True):
        with open("motor_config.json", "w") as motor_config:
            json.dump({
                "pin": pin,
                "actuation_length": actuation_length,
                "interstep_delay": interstep_delay
            }, motor_config, indent=4)
    motor_config.close()
    UI.quit_program()

#-------------------------------------------------------------------------------------------------
#   Main menu
#-------------------------------------------------------------------------------------------------

options_home = [
    {
        "text": "DEBUG_MODE",
        "color": "white",
        "id": "debug",
        "func": {
            "body": set_debug,
            "param": []
        }
    },
    {
        "text": "set serial port(required to connect to board)",
        "color": "yellow",
        "id": "serial",
        "func": {
            "body": set_serial,
            "param": []
        }
    },
    {
        "text": "setup for pin layout",
        "color": "green",
        "id": "pin",
        "func": {
            "body": setup_pin,
            "param": []
        }
    },
    {
        "text": "caliberate actuation length",
        "color": "magenta",
        "id": "length",
        "func": {
            "body": setup_length,
            "param": []
        }
    },
    {
        "text": "adjust interstep delays",
        "color": "cyan",
        "id": "delay",
        "func": {
            "body": setup_delay,
            "param": []
        }
    },
    {
        "text": "quit and save (!ONLY THIS SAVES CONFIGURATION!)",
        "color": "red",
        "id": "quit save",
        "func": {
            "body": quit,
            "param": [True]
        }
    }
]
# Home menu prompt builder (display current configuration)
def home_prompt():
    return "\n".join([
        f"{coutput.get_print_string_text("====================================", color="white")}",
        f"{coutput.get_print_string_text("DEBUG MODE: ", color="red")}{coutput.get_print_string_text(DEBUG_MODE, color="yellow")}",
        f"{coutput.get_print_string_text("====================================", color="white")}",
        coutput.get_print_string_text("- SERIAL PORT:", color="red"),
        f"    {coutput.get_print_string_text("Connected to Arduino: ", color="white")}{coutput.get_print_string_text(port_name, color="yellow")}",
        coutput.get_print_string_text("- CURRENT CONFIGURATIONS:", color="red"),
        f"    {coutput.get_print_string_text("Pin layout: ", color="white")}{coutput.get_print_string_text(pin, color="yellow")}",
        f"    {coutput.get_print_string_text("Actuation length:", color="white")}",
        f"        {coutput.get_print_string_text("Forward: ", color="white")}{coutput.get_print_string_text(actuation_length.get("forward", None), color="yellow")}",
        f"        {coutput.get_print_string_text("backward: ", color="white")}{coutput.get_print_string_text(actuation_length.get("backward", None), color="yellow")}",
        f"    {coutput.get_print_string_text("Interstep delay:", color="white")}",
        f"        {coutput.get_print_string_text("Min(fastest): ", color="white")}{coutput.get_print_string_text(interstep_delay.get("min", None), color="yellow")}",
        f"        {coutput.get_print_string_text("Max(slowest): ", color="white")}{coutput.get_print_string_text(interstep_delay.get("max", None), color="yellow")}",
        f"{coutput.get_print_string_text("====================================", color="white")}"
    ])

UI.home_menu(name="Motor Setup", prompt=home_prompt, options=options_home)
