Mr-Cosine/EMG/Softwares/EMGsignal/src/queue.h

#ifndef QUEUE_H
#define QUEUE_H

#include "types.h"

template <typename dataType, int CAPACITY>
class Queue {
    private:
        dataType data[CAPACITY];
        i32 head;
        i32 tail;
        i32 used_amount;

        void push(dataType value) {
            if (used_amount == CAPACITY) return;

            this->data[tail] = value;
            this->tail = (this->tail + 1) % CAPACITY;
            this->used_amount+=1;
        }

        void pop() {
            if (used_amount == 0) return;

            this->head = (head + 1) % CAPACITY;
            this->used_amount-=1;
        }

    public:
        Queue(bool flush = false, dataType filler = dataType(0)):
            head(0),
            tail(0),
            used_amount(0)
        {
            if (flush) this->flush(filler);
        }

        void update(dataType newValue) {
            if (isFull()) this->pop();
            this->push(newValue);
        }

        void flush(dataType filler = dataType(0)) {
            for (i32 _ = 0; _ < CAPACITY; _++) this->update(filler);
        }

        dataType& operator[](i32 idx) { return data[(head + idx) % CAPACITY]; }
        const dataType& operator[](i32 idx) const { return data[(head + idx) % CAPACITY]; }

        i32 size() { return this->used_amount; }
        i32 size() const { return this->used_amount; }

        i32 capacity() { return CAPACITY; }
        i32 capacity() const { return CAPACITY; }

        bool isFull() { return this->used_amount == CAPACITY; }
        bool isFull() const { return this->used_amount == CAPACITY; }
};

#endif
