Mr-Cosine/EMG/(commit log)

2026-09-05 updated hardware components
    [Index finger v1.SLDASM, Middle finger v1.SLDASM, Pinky nail v1.SLDASM, Ring finger v1.SLDASM, Thumb.SLDASM, armband_base.SLDPRT, armpiece.SLDPRT, beam v2.SLDPRT]
2026-09-09 Update armband_base.SLDPRT
    updated the geometry of the armband base
    [armband_base.SLDPRT]
2026-09-10 code update for the motor test and model update
    [armband_base.SLDPRT, central support v5.SLDPRT, connector - big v5.SLDPRT, connector - tip v5.SLDPRT, connector v5.SLDPRT, handpiece v5.SLDPRT, index&ring finger v4.SLDASM, middle finger v4.SLDASM]
2026-09-10 typing management and adding release after actuation to prevent overheating
    [bipolar_stepper_motor.cpp, bipolar_stepper_motor.h, button_test.ino, test_drive.ino]
2026-09-12 added motor setup helper, pcb for manual toggle
    [PCB1.PcbDoc, PCB_testboard.PrjPcb, Sheet1.SchDoc, glider base_4_CNC_easy.SLDDRW, motor_config.json]
2026-09-12 finishes motor setup
    [motor_config.json]
2026-09-12 correctness fix
    [motor_config.json]
2026-09-12 updates pin
2026-09-12 updated prettier_console
    [motor_config.json]
2026-09-22 installs prettier-console and updates solidworks files
    [armband_base.SLDPRT, central support v5.SLDPRT, connector - big v5.SLDPRT, connector - tip v5.SLDPRT, connector v5.SLDPRT, glider base_4_CNC.STEP, glider base_4_CNC_easy.SLDDRW, handpiece v5.SLDPRT]
2026-09-29 updated mechanical design and created EMG PCB design
    [AMP1.SchDoc, AMP2.SchDoc, EMGfrontend.PcbDoc, EMGfrontend.PrjPcb, EMGfrontend.SchDoc, HPF(20Hz).SchDoc, LPF(500Hz).SchDoc, VREF.SchDoc]
2026-10-01 EMG sensor pcb v1.0 and minor code update
    [AMP1.SchDoc, AMP2.SchDoc, EMGfrontend.PcbDoc, HPF(20Hz).SchDoc, LPF(500Hz).SchDoc, VREF.SchDoc]
2026-10-02 EMG sensor pcb ver2.0 published
    [AMP1.SchDoc, AMP2.SchDoc, EMGfrontend.PcbDoc, EMGfrontend.PrjPcb, EMGfrontend.SchDoc, HPF(20Hz).SchDoc, LPF(500Hz).SchDoc]
2026-10-08 last v2.0 pcb update
2026-10-08 PCB v3.0 - unified component size + shrinked board size + better copper pour
2026-10-10 optimization of board shape and component layout
2026-10-12 restructures queue design, upgrades lpf and hpf to adapt different sample frequency and cut off frequency
2026-10-13 finished new filters
2026-10-13 placed pcb files together
2026-10-16 restructures files and added testing of the filters
2026-10-18 pcb version 4.0 published: better ADC routing, shrinked board size
2026-10-18 file restructure and pcb revision
2026-10-18 added more README, restructured some file, better pcb design
2026-10-24 minor optimizations on pcb
2026-10-30 pcb updates
2026-10-30 updates of pcb
2026-10-30 pcb update
2026-11-04 added the new integrated sensor board
2026-11-05 update on pcb document
2026-11-07 finished the intergrated board design
2026-11-10 finished pcb for emgintegrated
2026-11-10 corrections (need to change the thorugh hole receptor to smd
2026-11-11 restructures file and added arm project
2026-11-11 4 pin connector version pcb finished (checkpoint)
2026-11-11 board update
